Daiwei99/03_3-axis-stepper-motor/3 axis_motor_control_demo/MDK-ARM/schematic_renders/power-control_schematic_p2.png

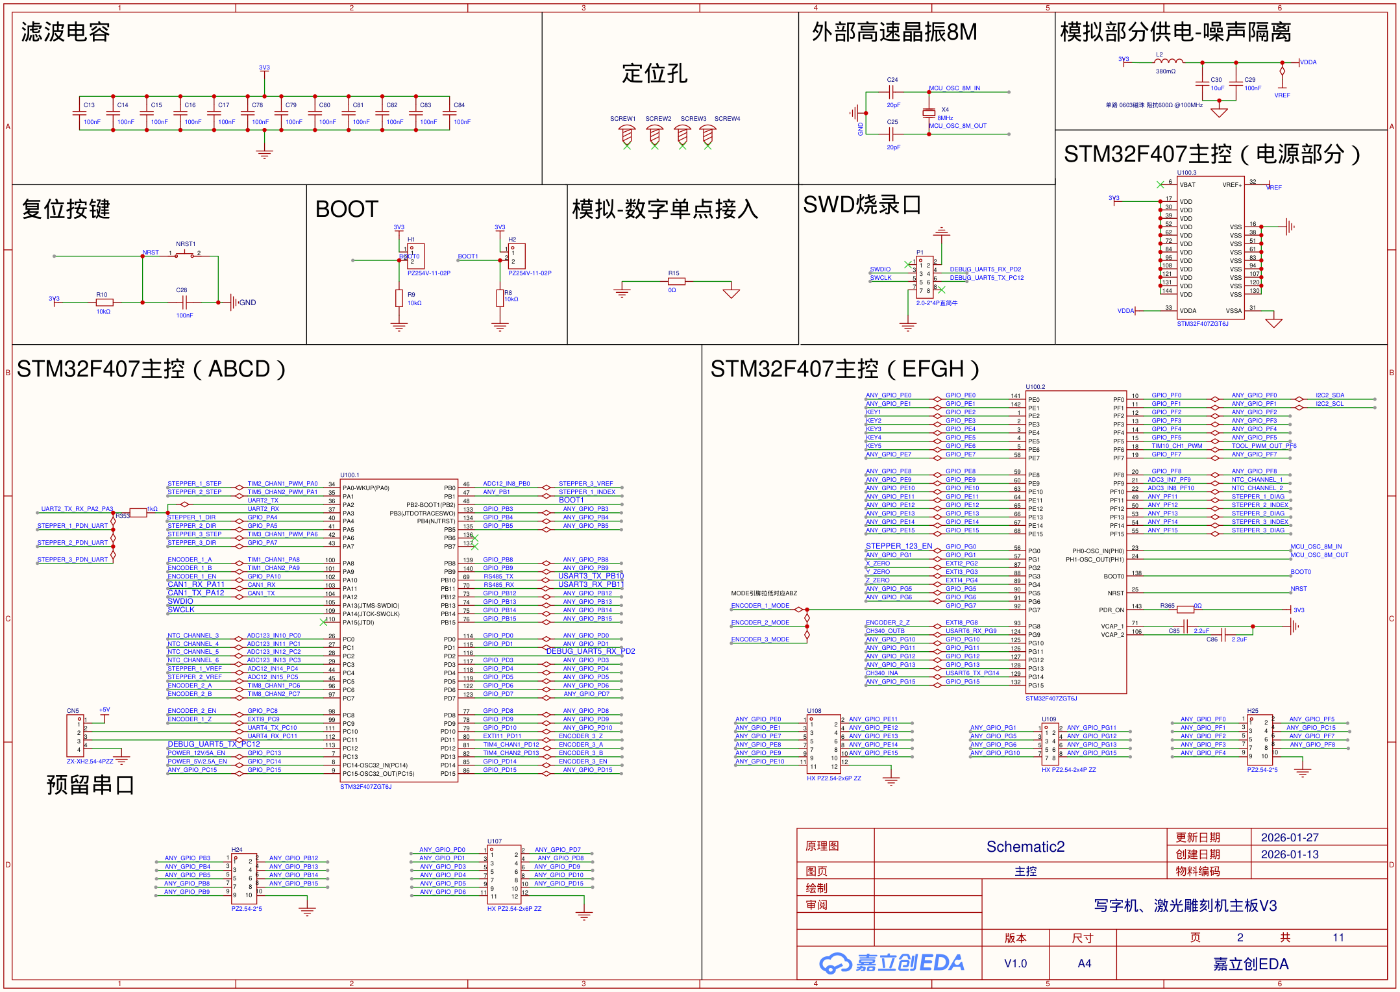
3 axis_motor_control_demo/MDK-ARM/schematic_renders/power-control_schematic_p2.png
