Daiwei99/03_3-axis-stepper-motor/3 axis_motor_control_demo/MDK-ARM/schematic_renders/TMC_schematic_p1.png

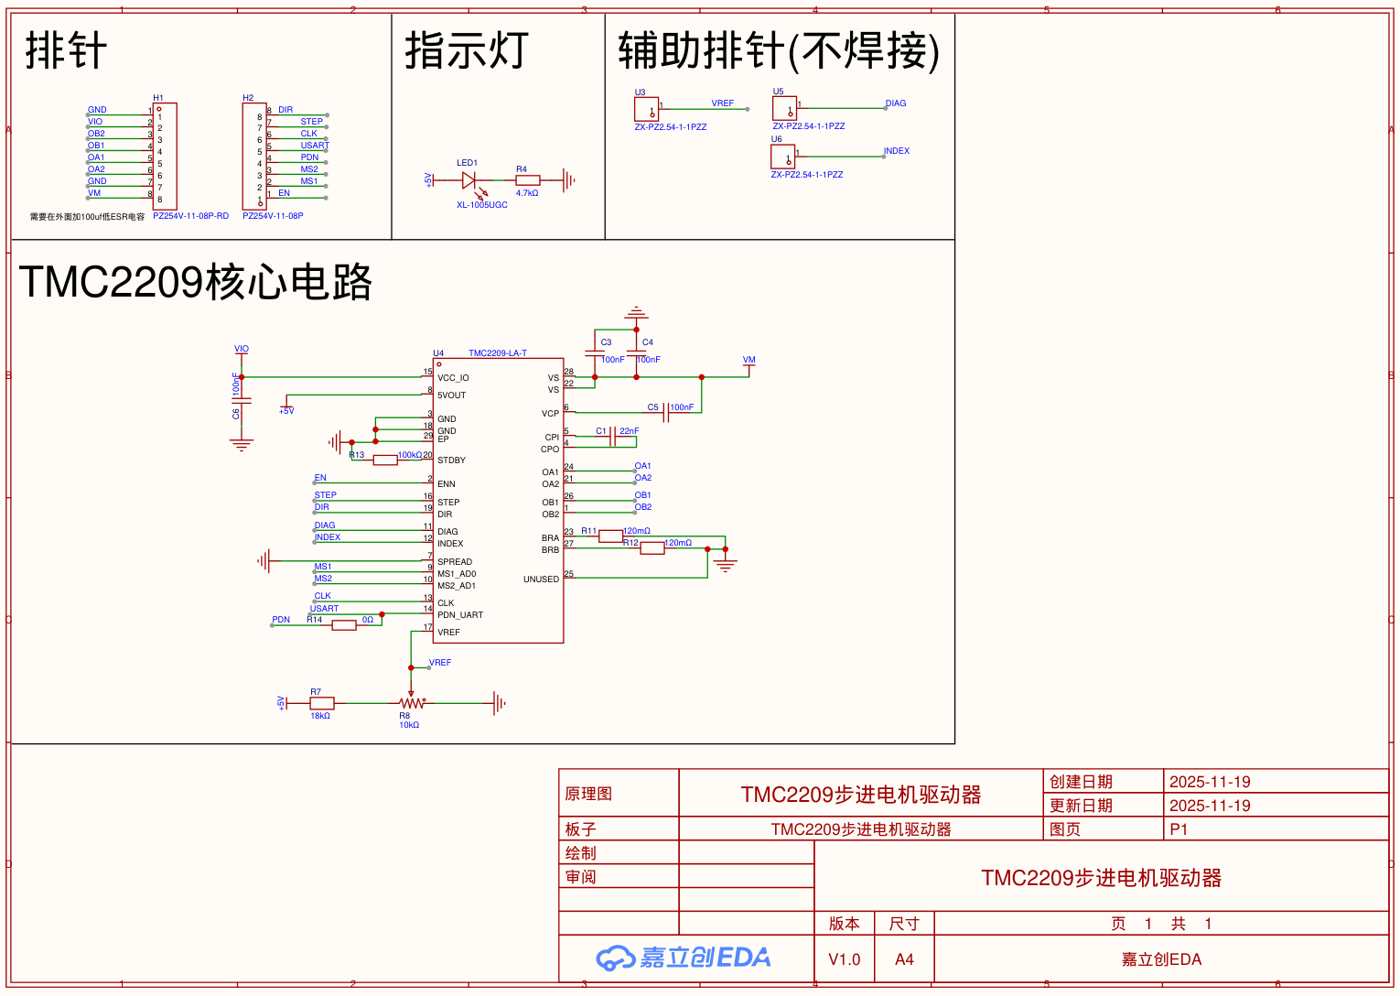
3 axis_motor_control_demo/MDK-ARM/schematic_renders/TMC_schematic_p1.png
