Daiwei99/03_3-axis-stepper-motor/3 axis_motor_control/01_3 axis_motor_control.ioc

Mcu.UserName=STM32F407ZGTx
PA0-WKUP.Signal=S_TIM2_CH1_ETR
PA11.Signal=CAN1_RX
PA12.Signal=CAN1_TX
PA13.Signal=SYS_JTMS-SWDIO
PA14.Signal=SYS_JTCK-SWCLK
PA4.GPIO_Label=STEPPER_1_DIR
PA4.Signal=GPIO_Output
PC12.Signal=UART5_TX
PC14-OSC32_IN.Signal=RCC_OSC32_IN
PC15-OSC32_OUT.Signal=RCC_OSC32_OUT
PD2.Signal=UART5_RX
PE2.GPIO_Label=KEY1
PE2.Signal=GPIO_Input
PE3.GPIO_Label=KEY2
PE3.Signal=GPIO_Input
PE4.GPIO_Label=KEY3
PE4.Signal=GPIO_Input
PE5.GPIO_Label=KEY4
PE5.Signal=GPIO_Input
PE6.GPIO_Label=KEY5
PE6.Signal=GPIO_Input
PG0.GPIO_Label=STEPPER_ALL_EN
PG0.Signal=GPIO_Output
PG2.GPIO_Label=X_ZERO
PG2.Signal=GPXTI2
PH0-OSC_IN.Signal=RCC_OSC_IN
PH1-OSC_OUT.Signal=RCC_OSC_OUT
