Daiwei99/03_3-axis-stepper-motor/3 axis_motor_control_demo/Core/Inc/main.h

#define KEY1_Pin GPIO_PIN_2
#define KEY1_GPIO_Port GPIOE
#define KEY2_Pin GPIO_PIN_3
#define KEY2_GPIO_Port GPIOE
#define KEY3_Pin GPIO_PIN_4
#define KEY3_GPIO_Port GPIOE
#define KEY4_Pin GPIO_PIN_5
#define KEY4_GPIO_Port GPIOE
#define KEY5_Pin GPIO_PIN_6
#define KEY5_GPIO_Port GPIOE
#define STEPPER_1_DIR_Pin GPIO_PIN_4
#define STEPPER_1_DIR_GPIO_Port GPIOA
#define STEPPER_ALL_EN_Pin GPIO_PIN_0
#define STEPPER_ALL_EN_GPIO_Port GPIOG
#define X_ZERO_Pin GPIO_PIN_2
#define X_ZERO_GPIO_Port GPIOG
#define X_ZERO_EXTI_IRQn EXTI2_IRQn
