Daiwei99/03_3-axis-stepper-motor/3 axis_motor_control_demo/MDK-ARM/source/App/App_Main.h

#ifndef __APP_MAIN_H__
#define __APP_MAIN_H__

#include "stm32f4xx_hal.h"
#include "stdio.h"
#include "Int_Motor.h"
#include "Com_DWT.h"
#include "Int_KEY.h"



void App_Main(void);



#endif /* __APP_MAIN_H__ */
