Daiwei99/03_3-axis-stepper-motor/(commit log)

2026-08-06 Finish step motor project
2026-08-07 项目总结
