Daiwei99/03_3-axis-stepper-motor/(notices)

Notices in the files:
3 axis_motor_control_demo/Core/Inc/main.h:
Copyright (c) 2026 STMicroelectronics.
All rights reserved.
This software is licensed under terms that can be found in the LICENSE file
